ClearGrass/Amber-S/SCH-PCB/MB/Readme.docx

1. 增加硬件看门狗电路，解决死机问题。（目前为止，4000套里面只发现1套死机，未寄送回来确认。）SMT时 R28不贴。

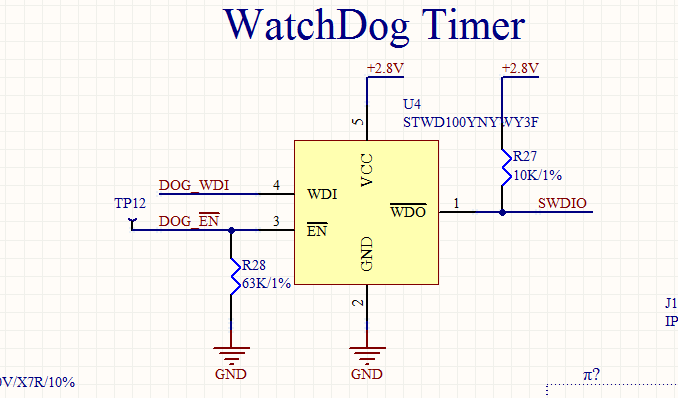
[picture p1: figure]
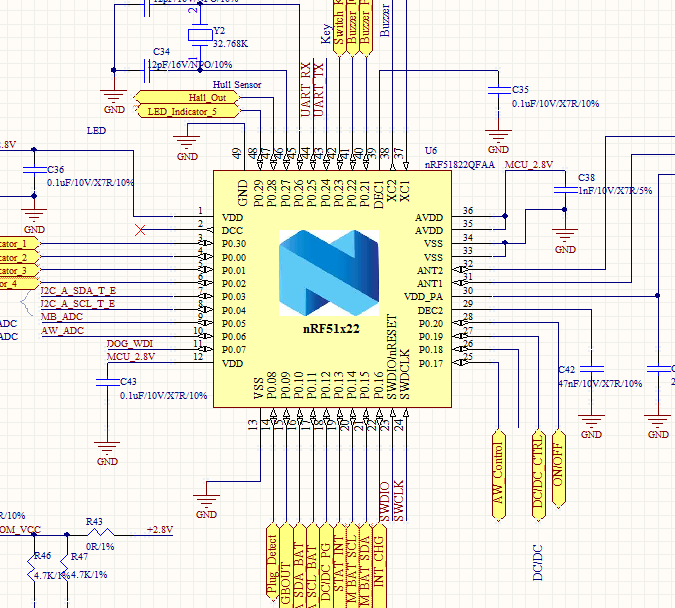
[picture p2: figure]

2. 充电部分，增加滤波磁珠，解决EMC 充电时辐射超标；（待定）

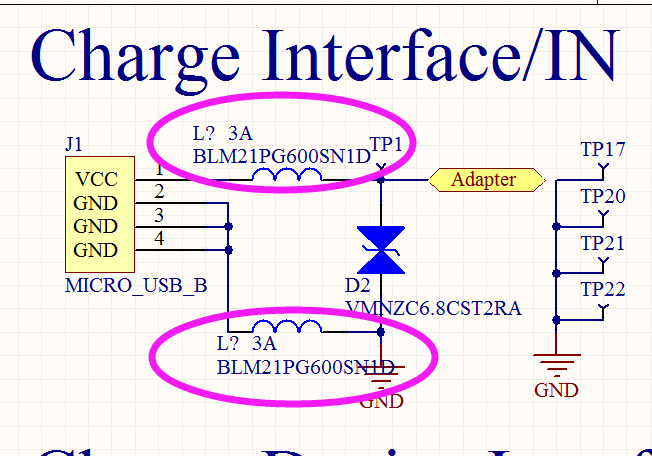
[picture p3: figure]

3. 放电部分，增加滤波磁珠，解决EMC 主USB放电时辐射超标；

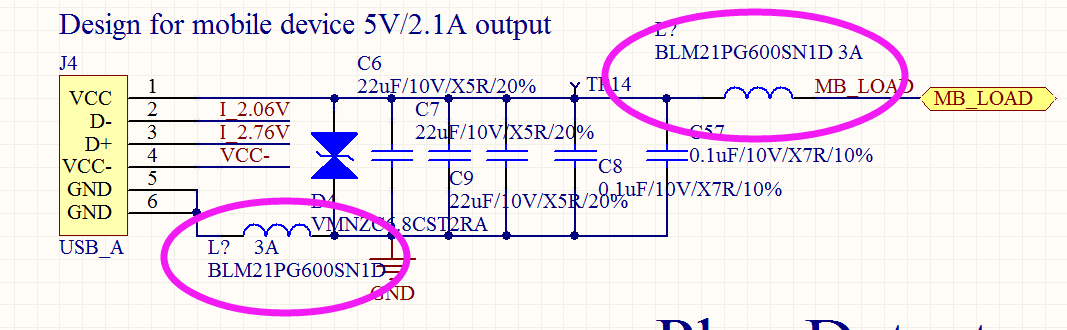
[picture p4: figure]

4. RF辐射信号测试较弱，Nordic给的建议：

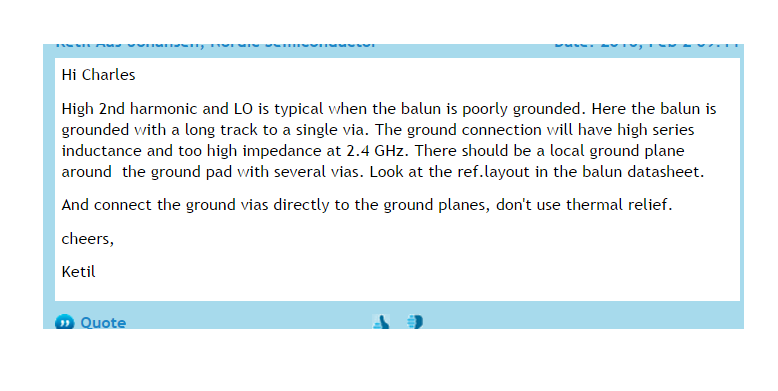
[picture p5: figure]

铺地改用实心铺铜，适用于高频；

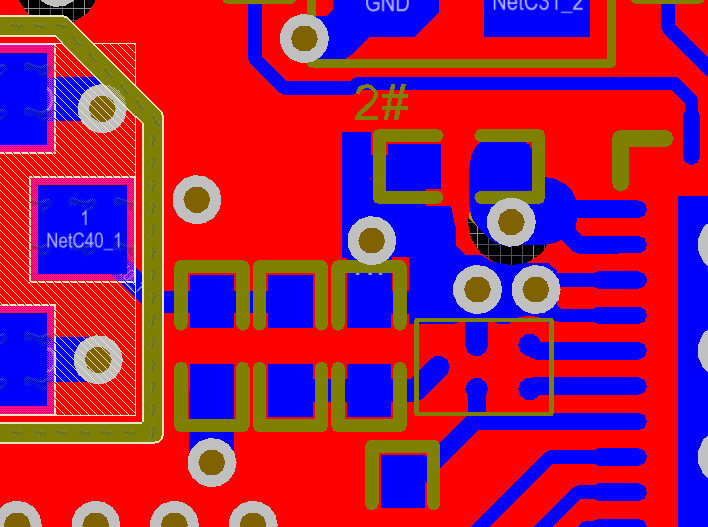
[picture p6: figure]

5. DRZ封装焊盘间距由0.14MM增加到0.16MM；

Y坐标由0.26MM改为0.24 MM；

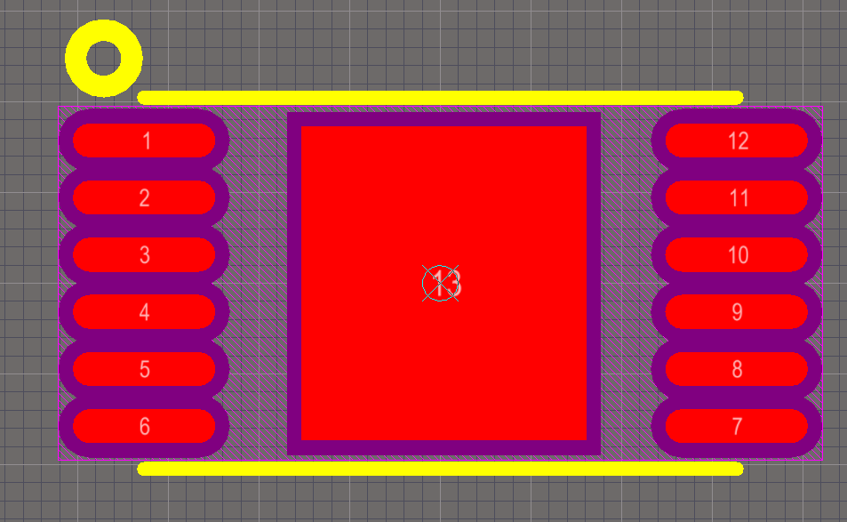
[picture p7: figure]
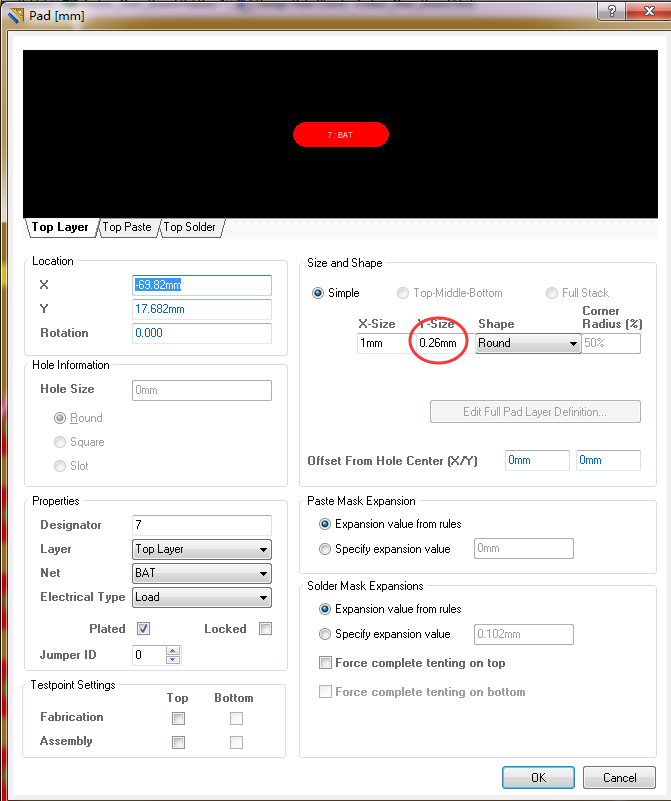
[picture p8: figure]

6. YFF封装焊盘由0.3MM减小到0.25MM；

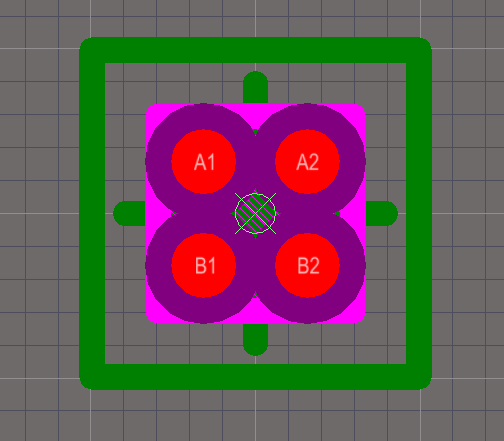
[picture p9: figure]

7. USB FCI母座焊盘增加0.1mm，为了解决P4 4K存在个别USB母座虚焊；Y坐标由1.12MM改为1.22MM；

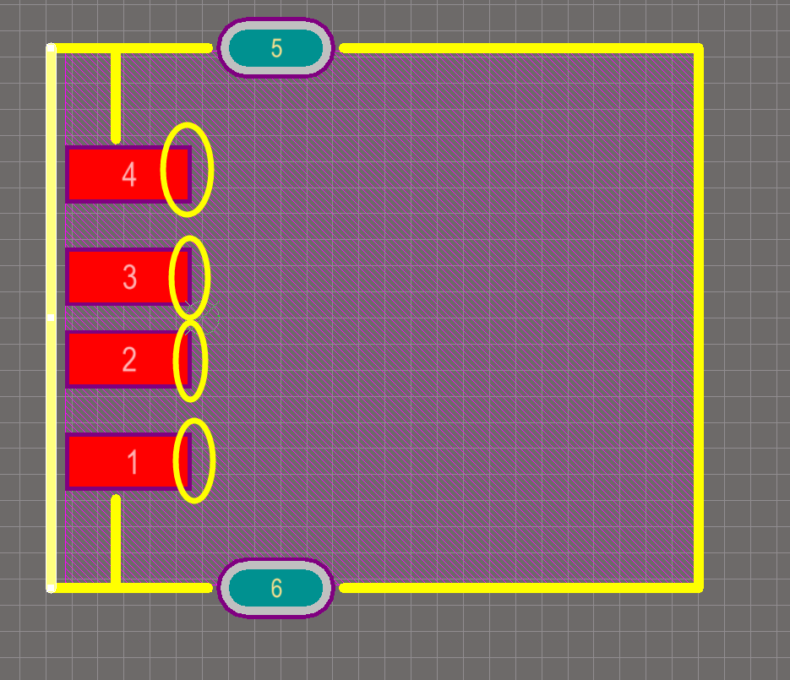
[picture p10: figure]
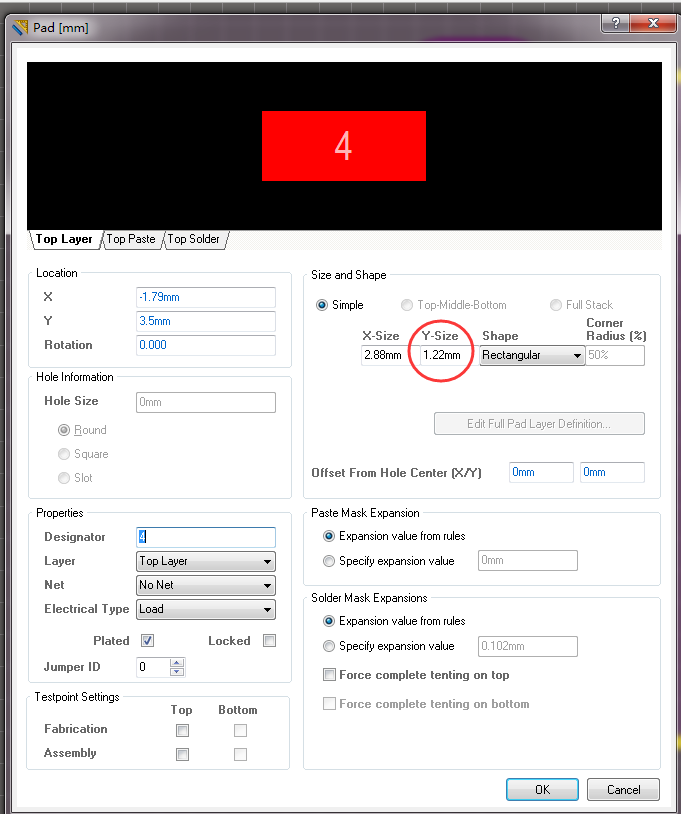
[picture p11: figure]
