ClearGrass/Amber-S/DataSheet/步进电机/出线顺序.png

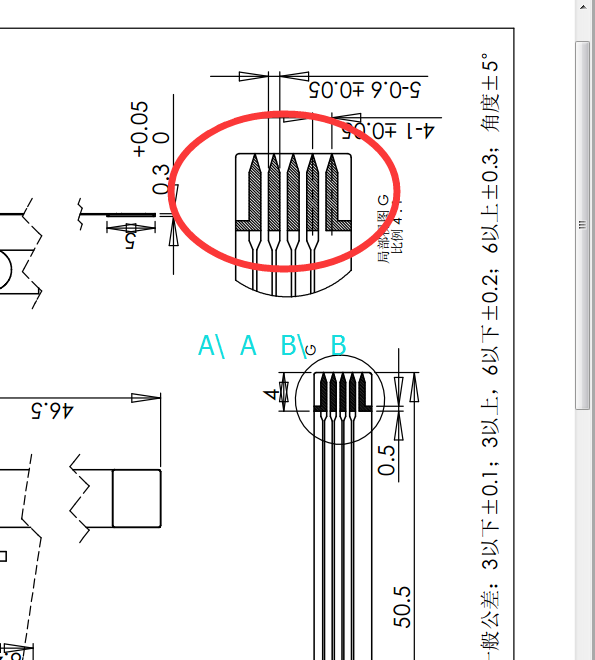
DataSheet/步进电机/出线顺序.png
