ClearGrass/Amber-S/DataSheet/步进电机驱动IC/Allegro/原厂联系方式.png

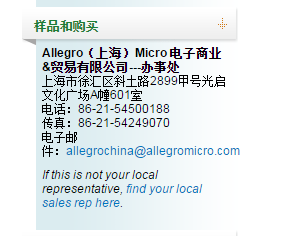
DataSheet/步进电机驱动IC/Allegro/原厂联系方式.png
