ClearGrass/Amber-S/DataSheet/步进电机/唯可泰/3D/motor10mm_asm.stp

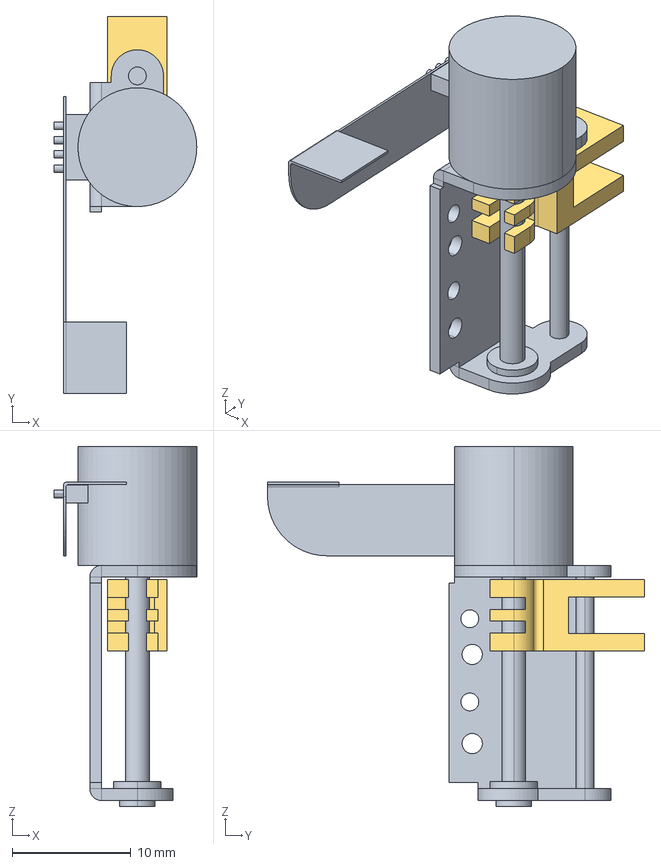
[picture p14: CAD file, 2016-07-05]
DataSheet/步进电机/唯可泰/3D/motor10mm_asm.stp
12.0 x 31.7 x 30.3 mm
MOTOR_METAL
MOTOREE
MOVE
