ClearGrass/Amber-S/(list of files, drawings)

Other design files:
SCH-PCB/MB/Amber_Main_Board.PcbDoc
SCH-PCB/MB/Amber_Main_Board.PrjPCB
SCH-PCB/MB/BLE MCU,Watch Dog and Reset,EEPROM,Buzzer.SchDoc
SCH-PCB/MB/Breath LED,Temp,Touch key,Motor.SchDoc
SCH-PCB/MB/Charge,Discharge,Battery Monitor,DC DC BUCK.SchDoc
SCH-PCB/MB/Management of Charging,Discharging,Tri-axis angle sensor.SchDoc
SCH-PCB/MB/WindCharger.SchDoc
SCH-PCB/Motor/Remote 8-bit I2C .SchDoc
SCH-PCB/Motor/Step Moter Control.SchDoc
SCH-PCB/SW/Amber.PcbLib
SCH-PCB/SW/Switch.PcbDoc
SCH-PCB/SW/Switch.SchDoc
SCH-PCB/SW/Swtich.PrjPCB
SCH-PCB/SW/Swtich.SCHLIB
