ClearGrass/Amber-S/(commit log)

2016-07-05 添加DataSheet文档
    添加DataSheet文档
2016-07-05 包含原理图以及PCB；
    包含原理图以及PCB；
2016-07-05 资料增加
    资料增加
    [Amber.PcbLib, Amber.SCHLIB, Amber_Main_Board.PcbDoc, Amber_Main_Board.PrjPCB, BLE MCU,Watch Dog and Reset,EEPROM,Buzzer.SchDoc, Breath LED,Temp,Touch key,Motor.SchDoc, Charge,Discharge,Battery Monitor,DC DC BUCK.SchDoc, Management of Charging,Discharging,Tri-axis angle sensor.SchDoc]
2016-07-08 上传新的文件
    [Remote 8-bit I2C .SchDoc]
2016-07-11 新增步进电机文件夹
2016-07-11 新增MB文件夹
2016-07-11 新增按键文件夹
2016-07-11 I2C转GPIO接口
    [Remote 8-bit I2C .SchDoc]
2016-07-11 上传电机驱动电路
    [Step Moter Control.SchDoc]
2016-07-11 上传PCB文件
    [Step Moter Control.PcbDoc]
2016-07-11 上传错位置，故删除
    [Step Moter Control.PcbDoc]
